CJ1219/peanut-picking-machine/硬體報告_qa/assets/LINE_ALBUM_機器照片_260907_2.jpg

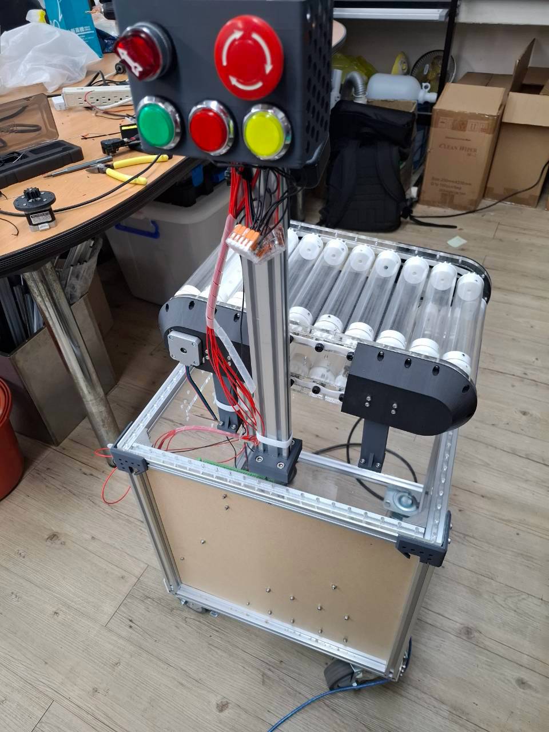
硬體報告_qa/assets/LINE_ALBUM_機器照片_260907_2.jpg
