CJ1219/peanut-picking-machine/archive_legacy/README.md

# 舊版程式封存

目前正式入口是根目錄的 `run_gui.py`。本資料夾保留不再作為生產入口的舊版程式，方便日後查閱或比對；請勿從這裡啟動生產系統。

- `detect.py`：舊版辨識入口。
- `gopro_arduino.py`：早期獨立 GoPro／Arduino 鍵盤控制程式。
- `main_control.ino.before_gui_integration.bak`：Arduino 整合前備份。
- `arduio_legacy_snapshot`：舊版專案副本。
