CJ1219/peanut-picking-machine/peanut_app/model_registry.py

from __future__ import annotations

import hashlib
from pathlib import Path


def file_hash(path: Path) -> str:
    if not path.exists():
        return "missing"
    digest = hashlib.sha256()
    with path.open("rb") as handle:
        for block in iter(lambda: handle.read(1024 * 1024), b""):
            digest.update(block)
    return digest.hexdigest()[:16]
